0990/esp32-ai-usage/docs/材料表.md

# 材料表
## esp32c3 supermini模块
淘宝链接： https://e.tb.cn/h.RC1b54IfR1OxcUa?tk=y5kRgOyXVCd<br>
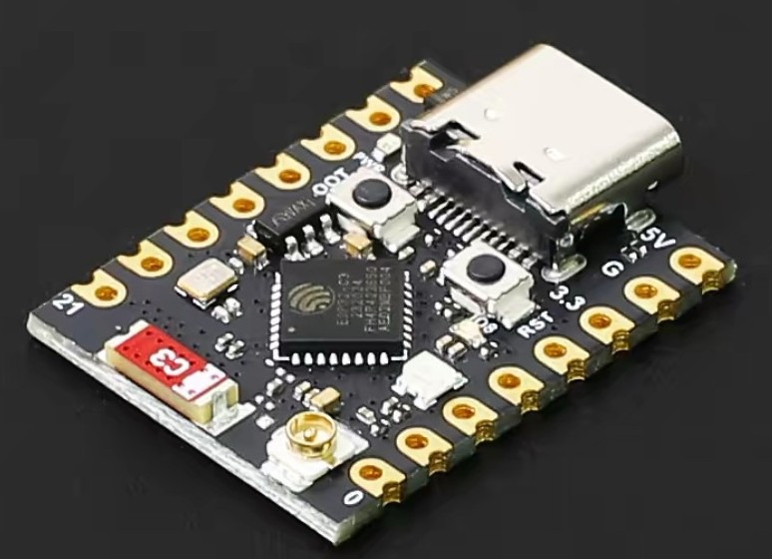
[picture p7: docs/images/datasheet_esp32c3.JPEG]


## 显示屏模块
规格: 0.91寸oled显示屏(4pin)<br>
淘宝链接： https://e.tb.cn/h.REEEVpy3dxMgBoe?tk=XN6GgOyVfkw<br>
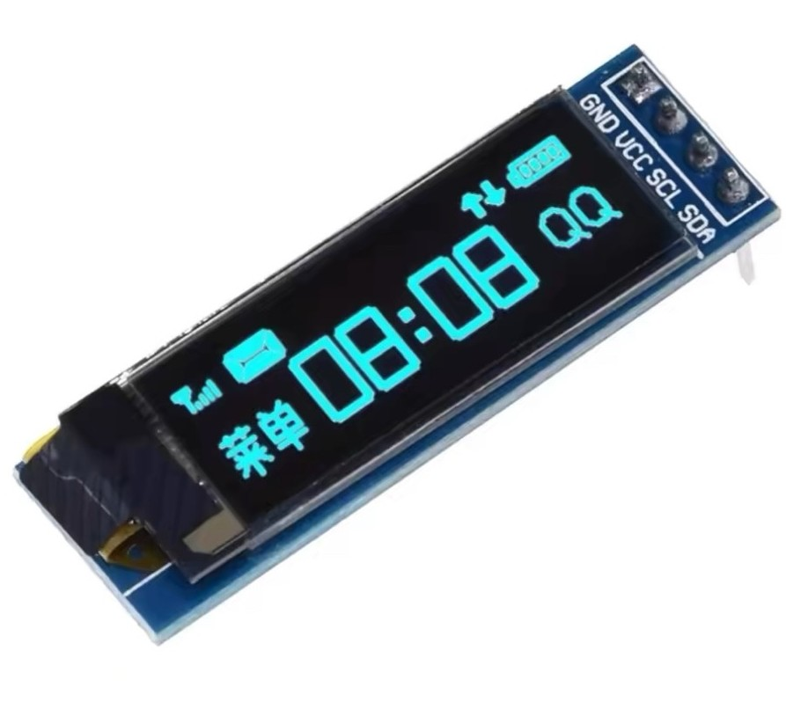
[picture p8: docs/images/datasheet_oled.JPEG]


## 圆柱棒/圆柱销（固定拨动杆和主体用)
规格: 2mm直径30mm长<br>
淘宝链接： https://e.tb.cn/h.REDxl5PxTem2MKx?tk=4y8ggOz7Rtr 
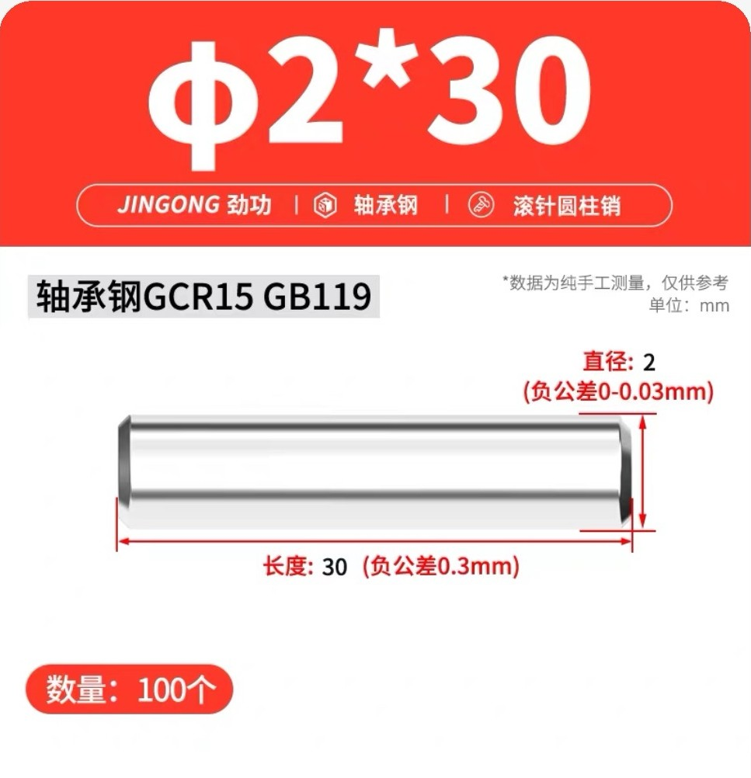
[picture p9: docs/images/datasheet_rod.JPEG]


## 波珠螺丝(拨动杆拨动嘎嘎响用)
规格: M4*8<br>
淘宝链接： https://e.tb.cn/h.RwsddgNgJnvsKuQ?tk=cdxCgOygthc<br>
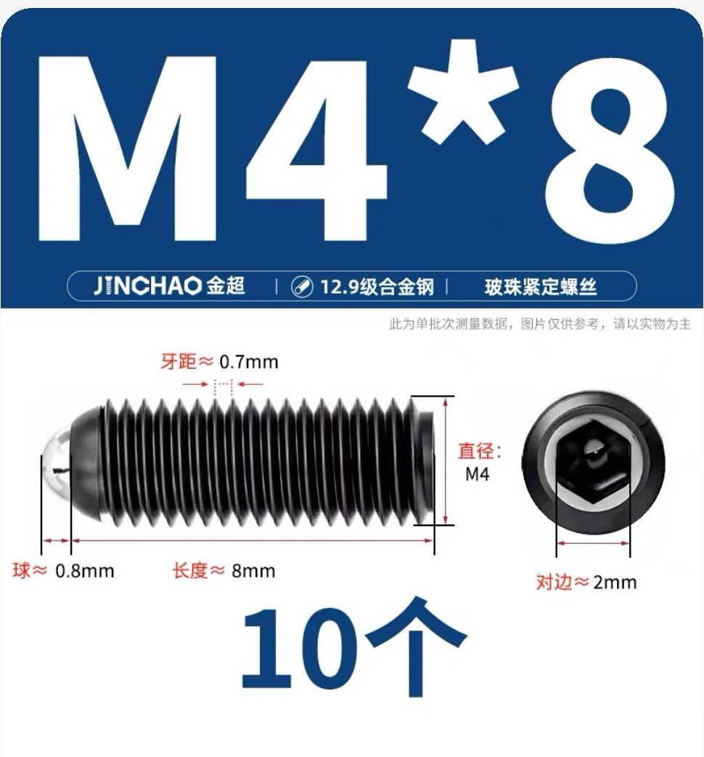
[picture p10: docs/images/datasheet_roll.JPEG]


## 连接线
规格: 28awg 4芯<br>
淘宝链接： https://e.tb.cn/h.REEwDEovPhZ6OM4?tk=Zk8zgOyf5Kr<br>
备注：此款需要剥最外套的皮，不然穿不进。连接线可随便购买，只要能穿进就行
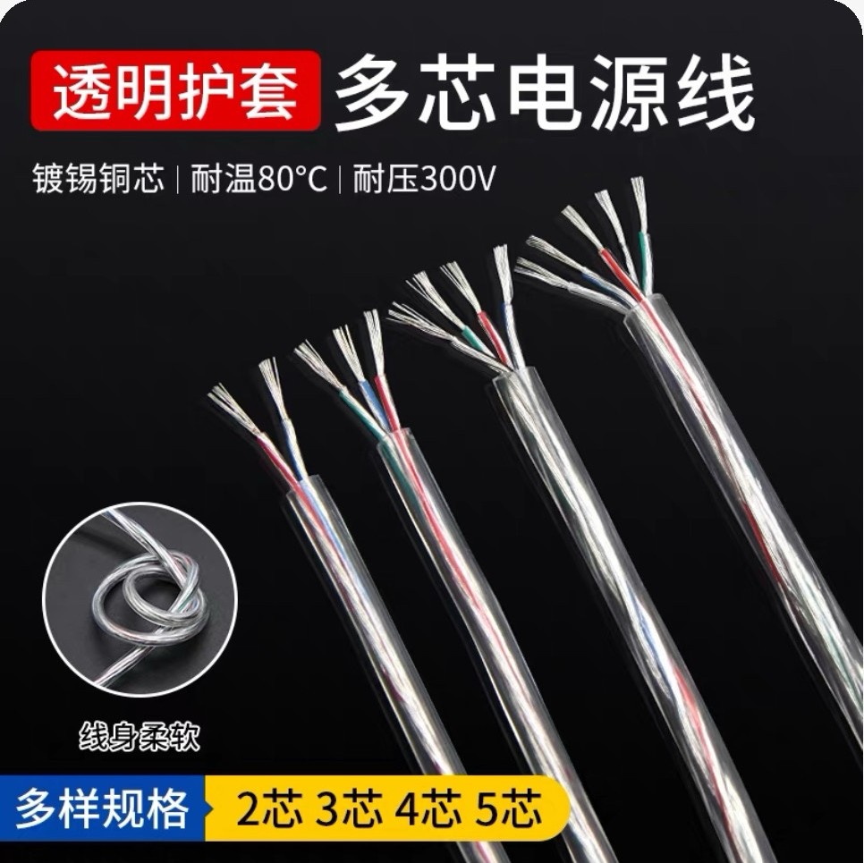
[picture p11: docs/images/datasheet_wire.JPEG]
