0990/esp32-ai-usage/docs/硬件安装.md

# 硬件安装
[材料表](./材料表.md)
## 安装步骤
### 一，显示屏装入拨动杆
1，显示屏焊接连接线<br>
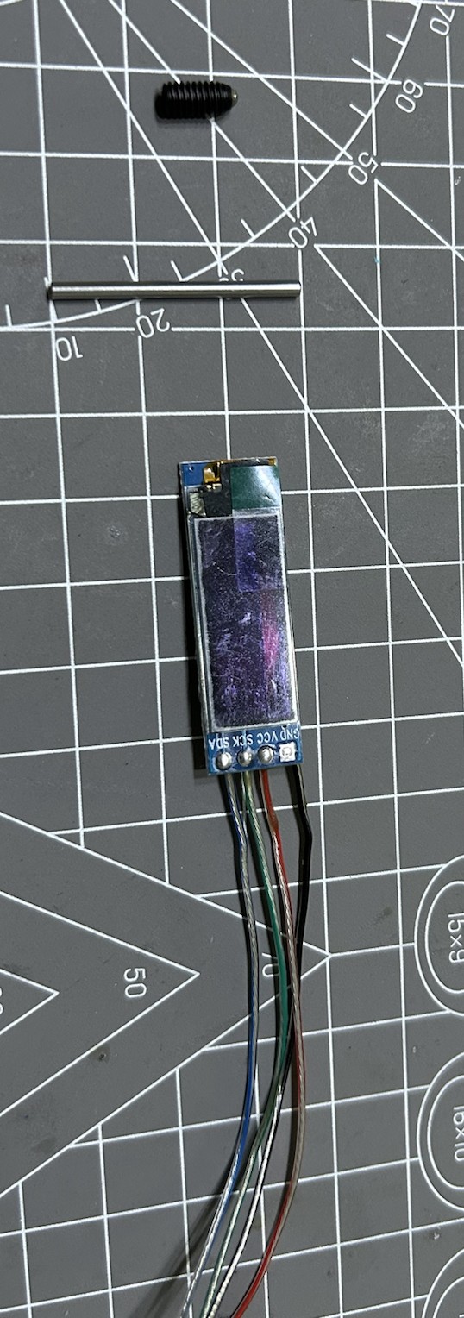
[picture p14: docs/images/hardware_datasheets.JPEG]
<br>
2，显示屏装入拨动杆槽<br>
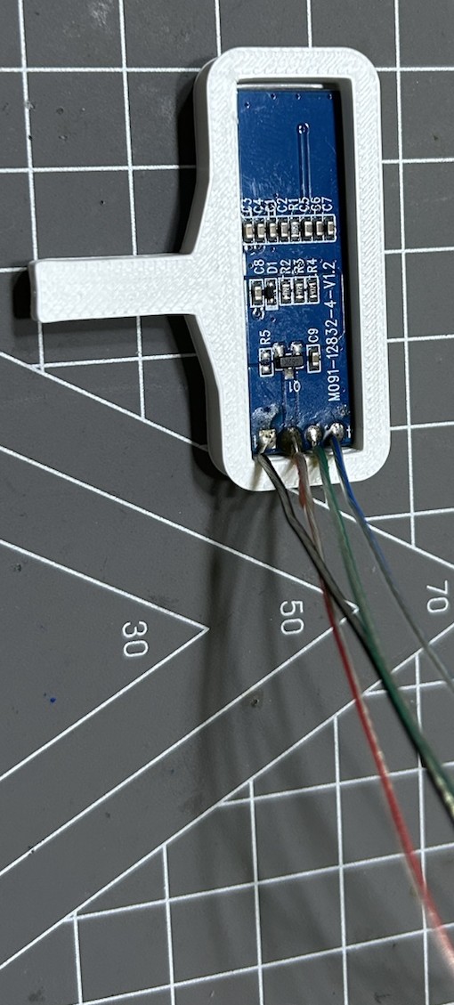
[picture p15: docs/images/hardware_oled1.JPEG]
<br>
3，拨动杆槽后盖安装，后盖孔出连接线<br>
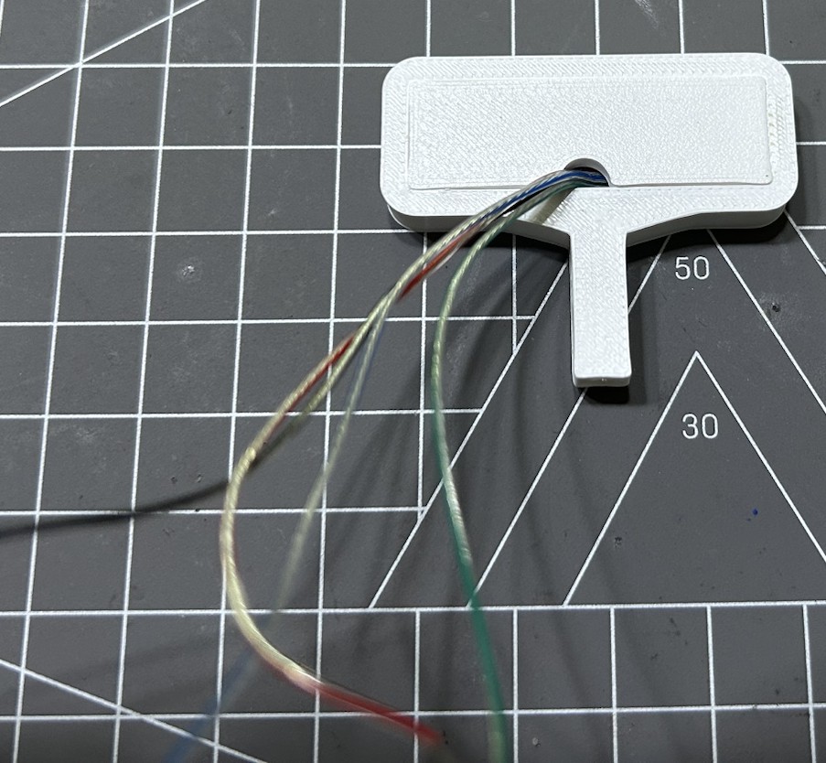
[picture p16: docs/images/hardware_oled2.JPEG]
<br>

### 二，拨动杆和主体连接
1，连接线穿入主体<br>
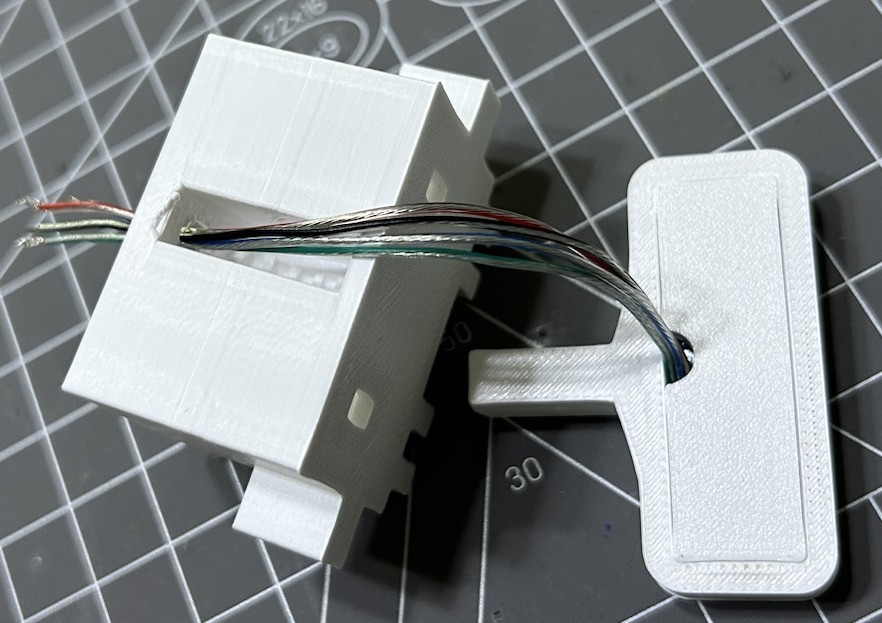
[picture p17: docs/images/hardware_oled_main_wire.JPEG]
<br>
2, 拨动杆装入波珠螺丝<br>
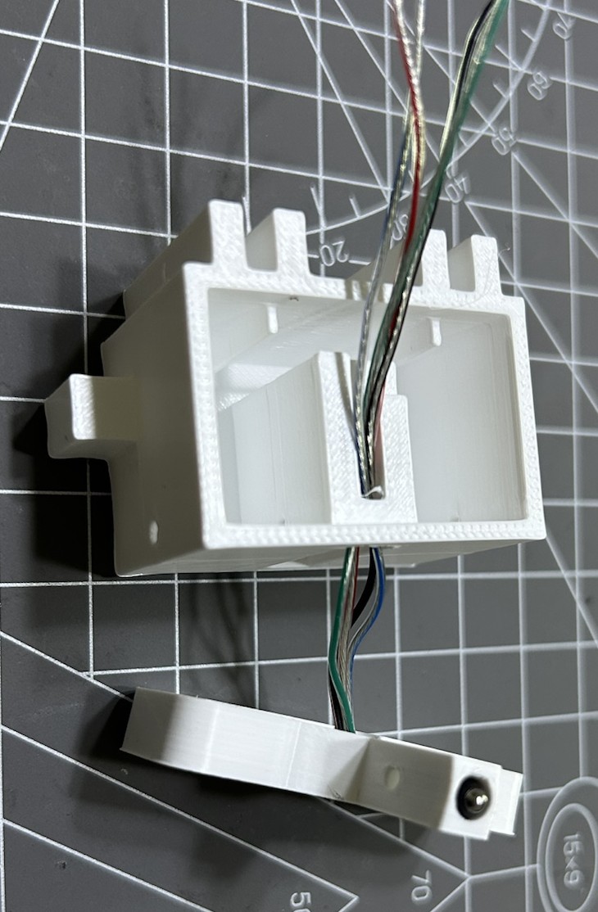
[picture p18: docs/images/hardware_oled_main_roll.JPEG]
<br>
3, 拨动杆和主体使用圆柱棒固定<br>
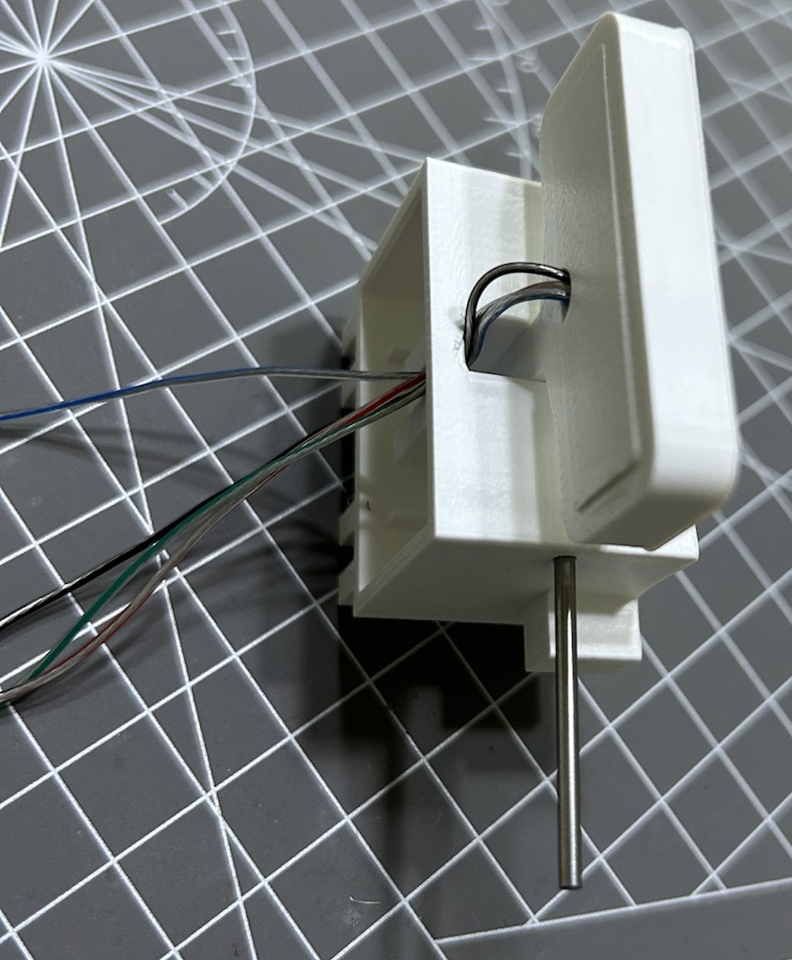
[picture p19: docs/images/hardware_oled_main_rod1.JPEG]
<br>
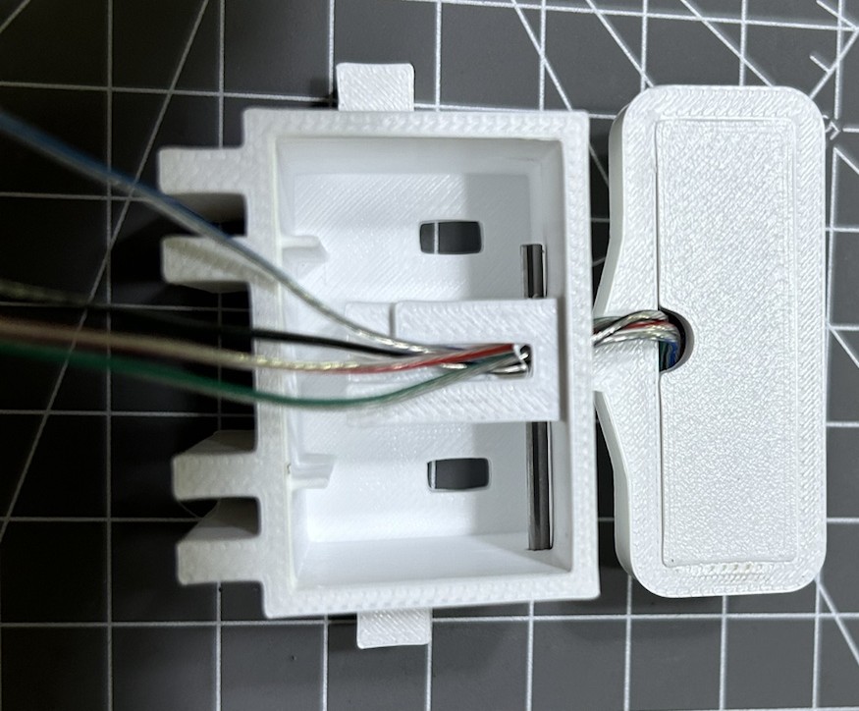
[picture p20: docs/images/hardware_oled_main_rod2.JPEG]
<br>

### 三，esp32c3焊接与固定
接线图：<br>
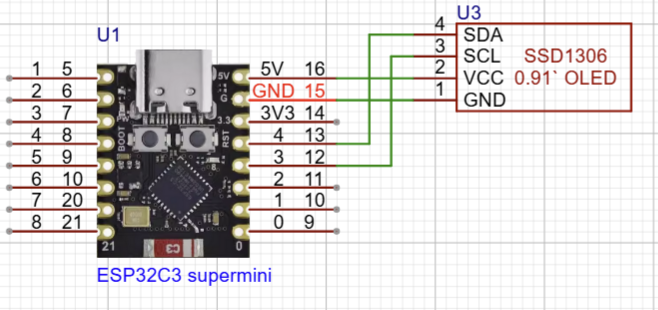
[picture p21: docs/images/hardware_oled_esp32_wire.png]
<br>
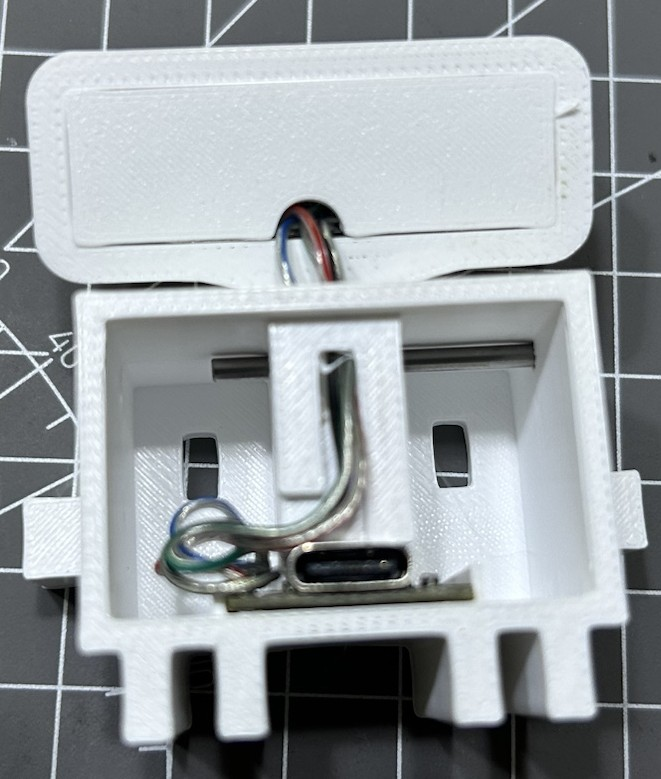
[picture p22: docs/images/hardware_esp32.JPEG]
<br>

### 四，装入后盖，竣工
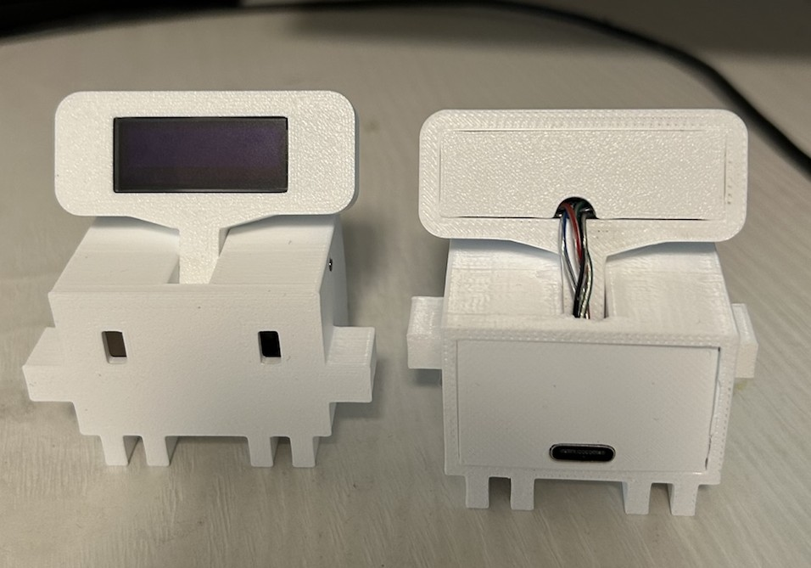
[picture p23: docs/images/hardware_final.JPEG]
<br>
