0990/esp32-ai-usage/docs/images/eu_show3.JPEG

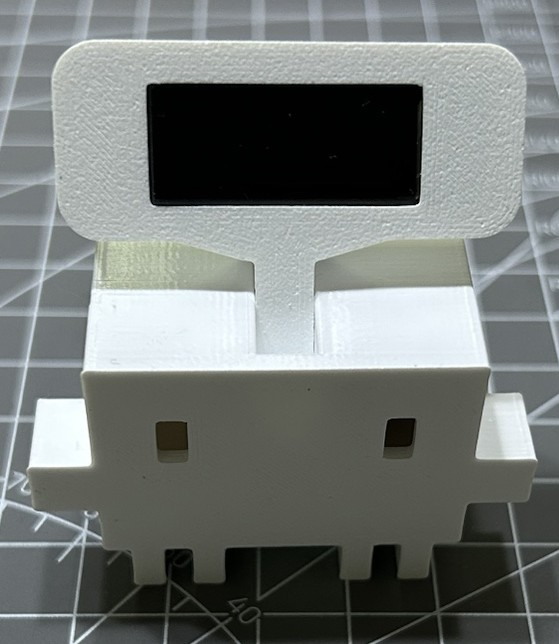
docs/images/eu_show3.JPEG
