0990/esp32-ai-usage/3dprint/拨动杆后盖.3mf

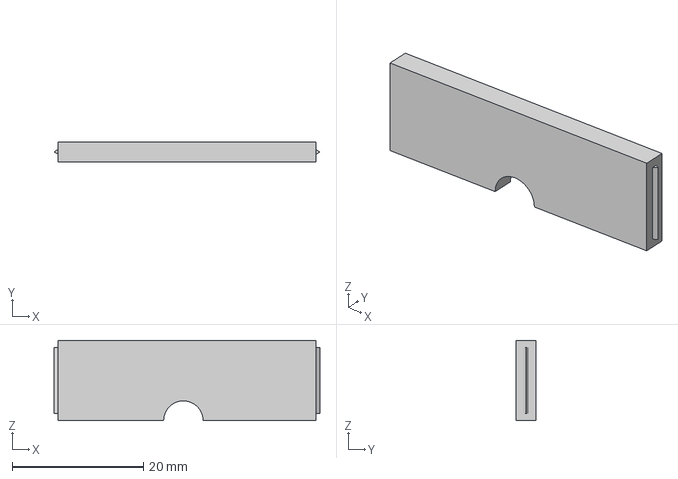
[picture p25: CAD file, 2026-07-05]
3dprint/拨动杆后盖.3mf
40.5 x 3.00 x 12.2 mm
