0990/esp32-ai-usage/3dprint/主体后盖.3mf

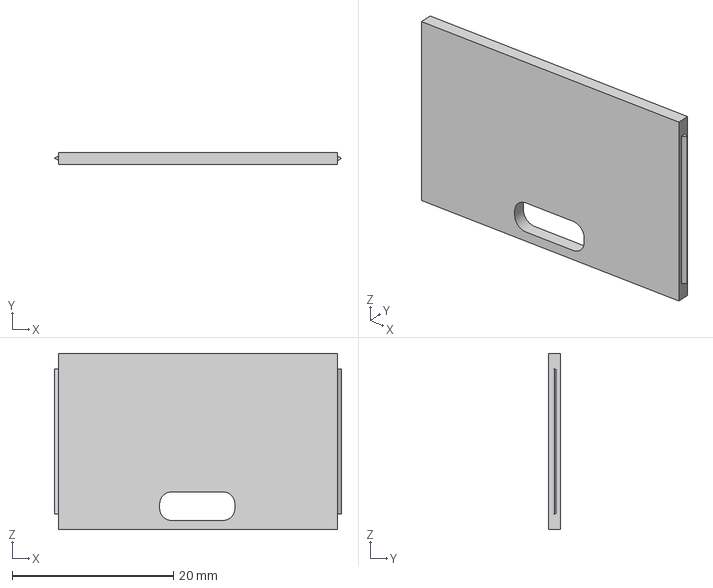
[picture p26: CAD file, 2026-07-05]
3dprint/主体后盖.3mf
35.6 x 1.50 x 21.9 mm
