0990/esp32-ai-usage/3dprint/all-in-one.3mf

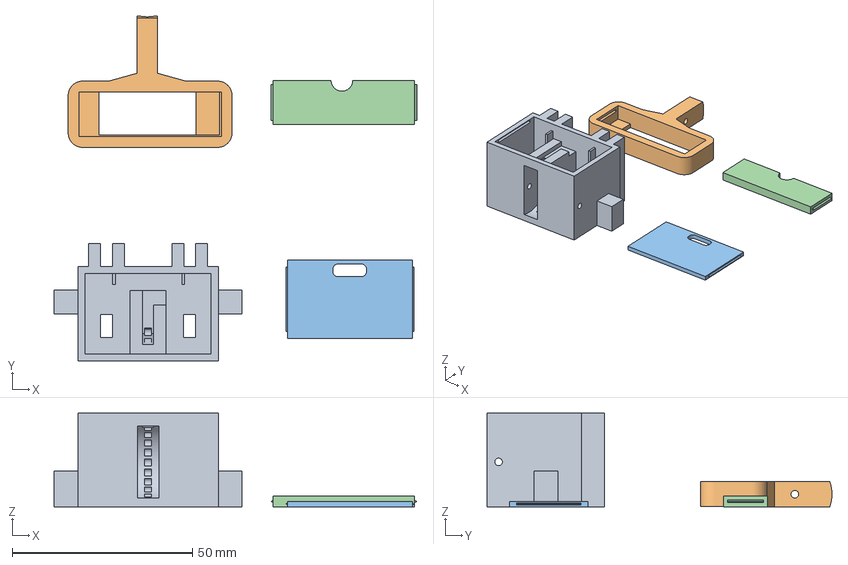
[picture p27: CAD file, 2026-07-05]
3dprint/all-in-one.3mf
100.7 x 95.8 x 26.0 mm
主体
拨动杆
主体后盖
oled后盖
