0990/esp32-ai-usage/3dprint/拨动杆.3mf

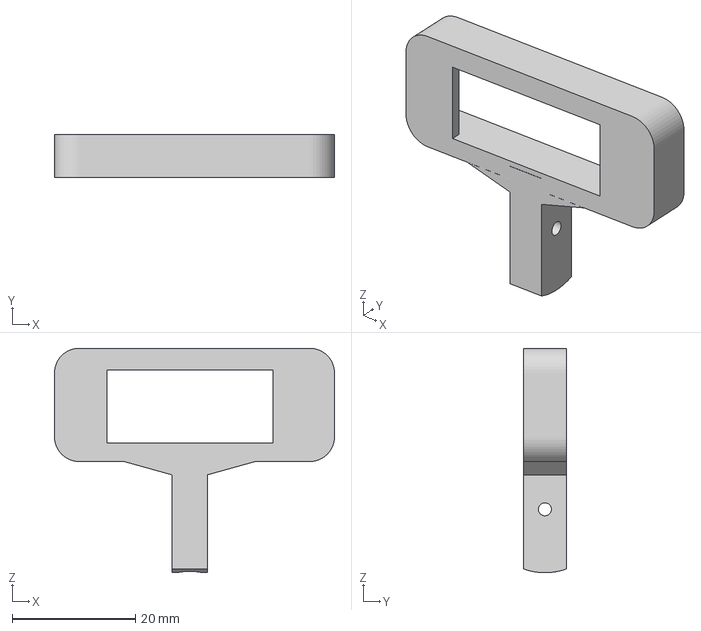
[picture p28: CAD file, 2026-07-05]
3dprint/拨动杆.3mf
45.5 x 7.03 x 36.5 mm
