0990/esp32-ai-usage/(list of files, cad)

Other CAD files:
3dprint/主体.3mf
