0990/esp32-ai-usage/(commit log)

2026-06-28 chore:加github action
2026-06-28 chore:icon改成透明的
2026-06-28 refactor: 项目改名 esp32-ai-credits → esp32-ai-usage
    统一可执行名、Go module 路径、App ID、User-Agent 及文档中的旧名。
    配置目录 ~/.esp32-ai-usage 原已是新名，未受影响。
2026-06-29 feat:oled换端口
2026-06-29 feat: 中转站页硬币改显大写 T
    money 帧只来自中转站，drawMoneyFrame 硬币上固定画 T（基线下移到圆心居中）。
2026-07-05 feat:增加硬件安装文档
2026-07-05 feat:优化文档
2026-07-05 feat:文档优化
2026-07-05 feat:文档更新
2026-07-09 feat:增加指示灯
2026-07-19 feat:优化claude中转站读取
2026-07-19 feat:增加kimi订阅余额查询
2026-07-22 fix:托盘点击就显示窗口
2026-07-22 feat:修复重新拔插esp32没被识别问题
2026-08-10 feat:监控对象支持多选（如同时勾 kimi+codex 轮播显示）
2026-09-02 feat:OLED 显示 Claude Code/Codex 运行标志 + 修复每分钟误刷新与启动等待屏
    - 运行标志：host 本地端口 127.0.0.1:52736 接收两家 CLI 的 hook 回调（activity.go），
    按会话记状态、按 provider 聚合成 Frame 的 a 字段（0 空闲/1 工作中/2 需要你）；
    设置页一键安装/移除钩子（hooks.go：Claude 写 settings.json http hook，
    Codex 写 hooks.json curl 命令 hook，需在 Codex 里 /hooks 信任）；固件工作中画跑动的点、
    等授权时图标闪烁，RGB 灯蓝呼吸/紫闪。
    - watcher 只认内容真的变了：ReClaude 每分钟重写 state.json 心跳不再触发 Reload，
    避免取数变成每分钟一次被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
2026-09-16 feat:「需要你」状态改为图标右上角脉动的「!」角标，替换整块 XOR 反色闪烁
    固件 drawActivity 的 a=2 分支不再把 24x32 图标区每 500ms 反色，改为
    drawAttentionBadge：图标右上角 (19,4) 画 r=4 圆角标 + 1px 黑边隔开图标，
    中间镂空「!」，每 400ms 在实心圆/空心圆环之间切换。只压住 Claude 图标
    右上角几个像素，Codex 图标与 money 页硬币不相交。RGB 灯紫闪逻辑不变。
    同步更新 PROTOCOL/README/docs/CLAUDE.md 里对该状态的描述。
2026-10-08 fix:修复auth.json不存在时的报错
2026-10-10 feat: add custom relay monitors and OLED brightness control
